skornsek/parking-gate/photos/remote-circuit.JPG

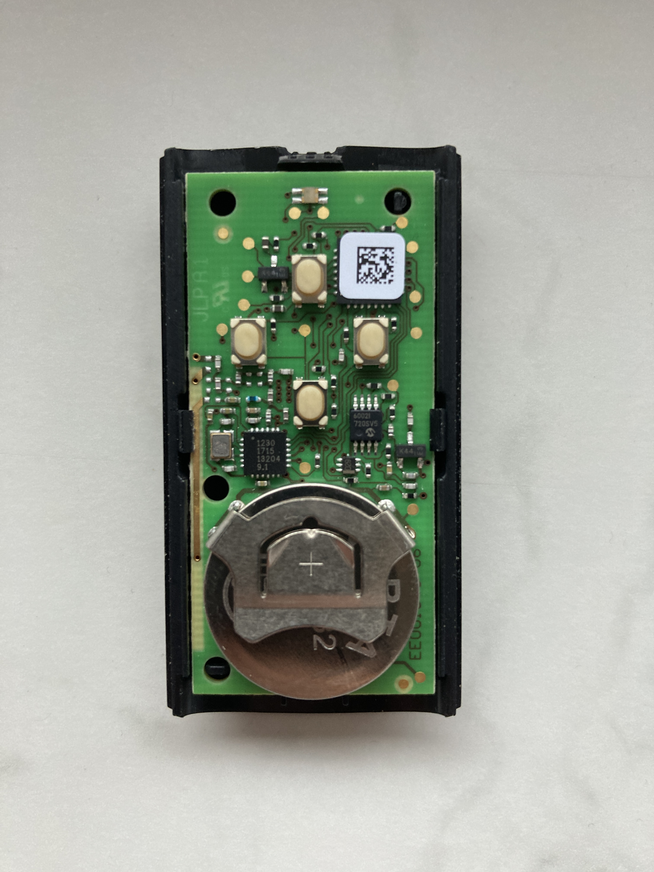
photos/remote-circuit.JPG
